denis-1337/NanoFanController/dutycycle_examplecurve.odp

Dutycycle %

Max 80%

P3 65%

P2 50%

Min 25%

P1 5%

0°C

P1 10°C

Temperature

P2 55°C

P3 80°C

100°C
