denis-1337/NanoFanController/menu_structure.odp

Display Mode

Display CH1

Display CH2

Display CH3

autoswitch

Setup (button down)

Save

General

CH1

CH2

CH3

ALL

DO SAVE!

AutoSwT

UpsideDwn

EnableCH

EnablePWM

EnableRPM
