denis-1337/NanoFanController/(commit log)

2024-06-16 Update NanoFanController.ino
    added pin constants
    fixed tacho pin constants to match hardware
    [NanoFanController.ino]
2024-06-16 Update NanoFanController.ino
    hardware channel fix
    [NanoFanController.ino]
2024-07-04 Update Schematics.png
    changed pwm and fan tacho channel numbering
2024-12-03 Update NanoFanController.ino
    upside down display mode bug (not completely fixable)
    [NanoFanController.ino]
